xfa273/NucleoMouse2023/README.md

WMMCで2023年頃から使っている標準機体のソフトです．古いtoolchainでしかビルドできない問題を修正してあるはずです．
