xfa273/NucleoMouse2023/hardware/cad/Nucleo_Mouse_Sensor-Bord_2023-0908.pdf

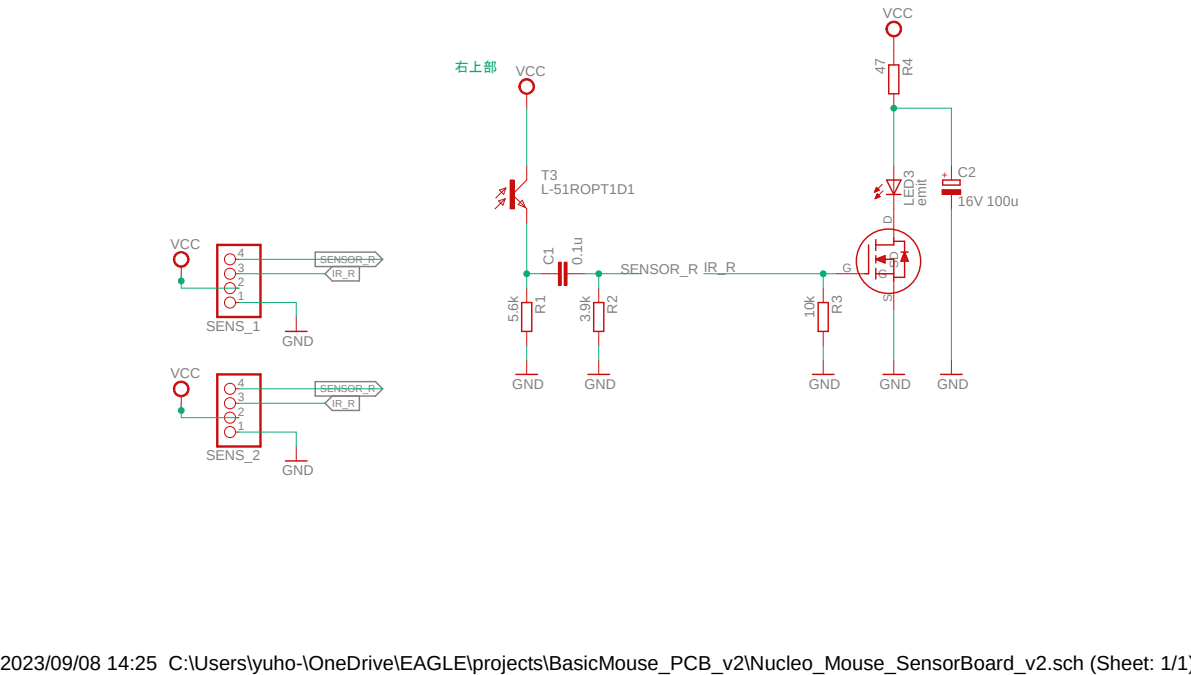
[picture p1: page 1]
2023/09/08 14:25 C:\Users\yuho-\OneDrive\EAGLE\projects\BasicMouse_PCB_v2\Nucleo_Mouse_SensorBoard_v2.sch (Sheet: 1/1) ⁵.6k; GND; L-51ROPT1D1; VCC; GND emit; C2 LED³ D; 4 SENS_1; 4 SENS_2; SENSOR_R; 右上部
