xfa273/NucleoMouse2023/hardware/cad/Nucleo_Mouse_Main-Bord_2023-0908.pdf

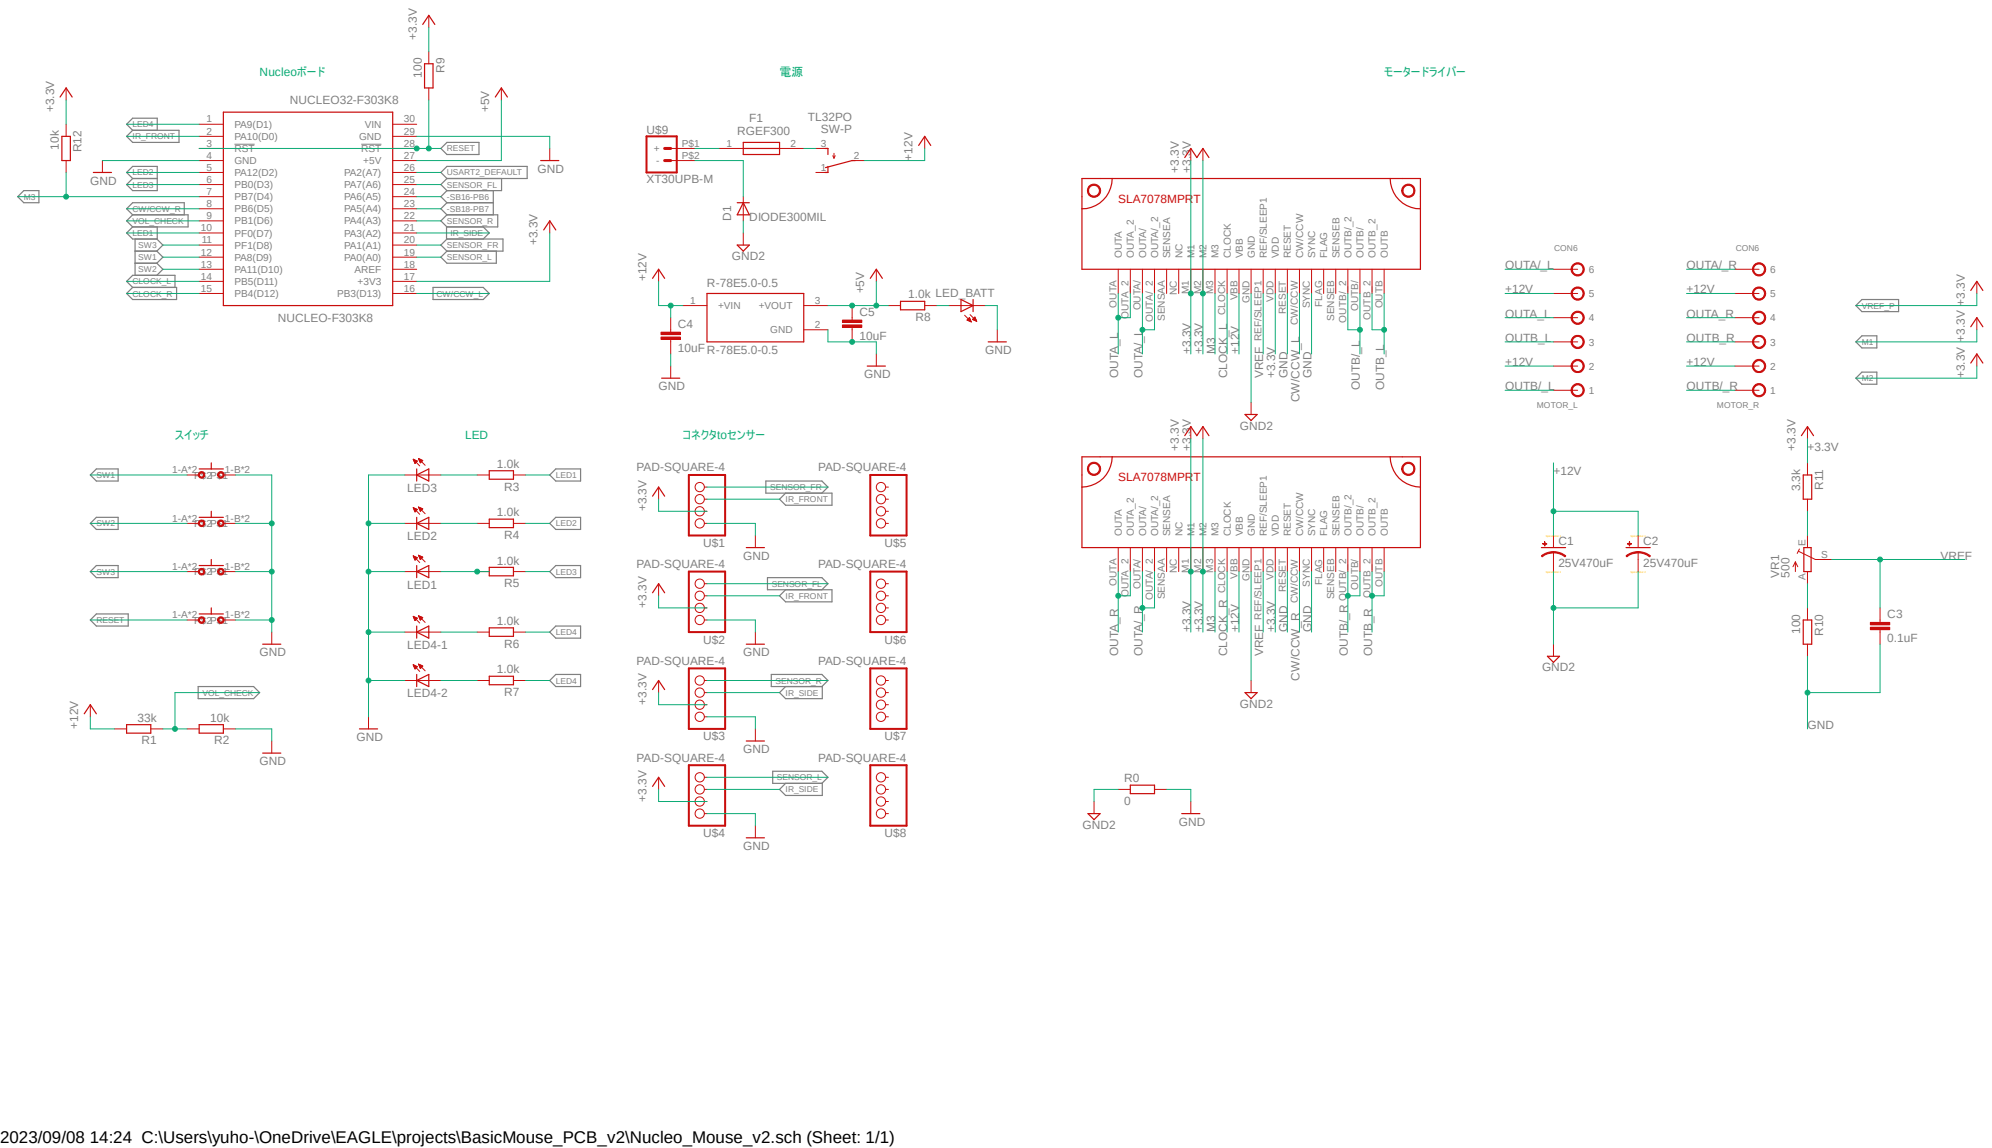
[picture p2: page 1]

2023/09/08 14:24 C:\Users\yuho-\OneDrive\EAGLE\projects\BasicMouse_PCB_v2\Nucleo_Mouse_v2.sch (Sheet: 1/1)
