xfa273/NucleoMouse2023/hardware/cad/Nucleo_Mouse_v2.brd

## EAGLE design hardware/cad/Nucleo_Mouse_v2.brd (2026-04-15)

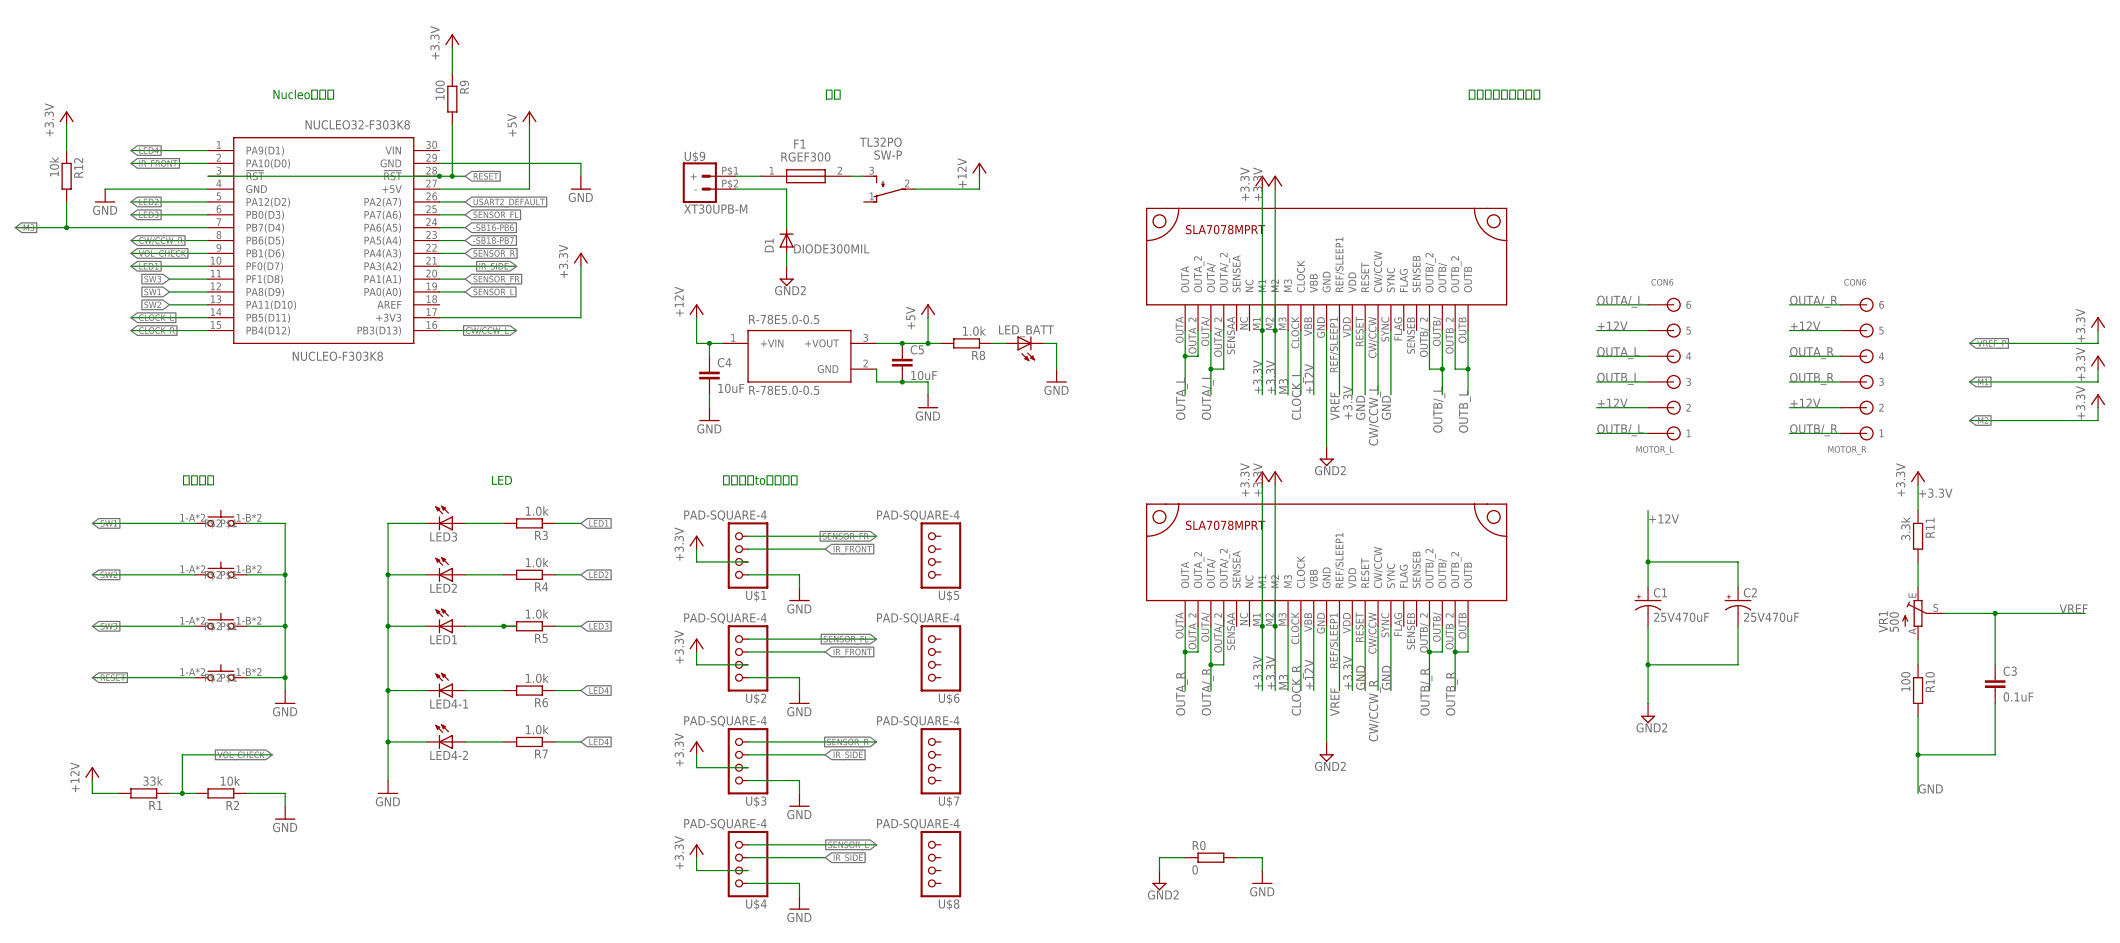
[picture p3: schematic Nucleo_Mouse_v2.sch]

Parts:
C1, C2: 25V470uF; E5-10,5
C3: 0.1uF; C050-024X044
C4, C5: 10uF; C050-024X044
D1: DIODE300MIL; D-7.5
DRIVER_L: SLA7078VANILLA; SLA7078_VANILLA
DRIVER_R: SLA7078VANILLA; SLA7078_VANILLA
F1: RGEF300
LED1, LED2, LED3, LED4-1, LED4-2: LED3MM
LED_BATT: LED3MM
MOTOR_L: CON6
MOTOR_R: CON6
NUCLEO32-F303K8: NUCLEO-F303K8; DIPS1524W66P254L5029H1500Q30N
R0: 0; 0204/7
R1: 33k; 0204/7
R2, R12: 10k; 0204/7
R3, R4, R5, R6, R7, R8: 1.0k; 0204/7
R9, R10: 100; 0204/7
R11: 3.3k; 0204/7
R-78E5.0-0.5: R-78E5.0-0.5; CONV_R-78E5.0-0.5
SW1, SW2, SW3: TACT_SW; AKI_TACT
SW-P: TL32PO; TL3XPO
SW_RESET: TACT_SW; AKI_TACT
U$1, U$2, U$3, U$4, U$5, U$6, U$7, U$8: PAD-SQUARE-4; PAD-SQUARE-2.54
U$9: XT30UPB-M
VR1: 500; B25P

Connections:
+3.3V: DRIVER_L.M1, DRIVER_L.M2, DRIVER_L.VDD, DRIVER_R.M1, DRIVER_R.M2, DRIVER_R.VDD, NUCLEO32-F303K8.17 (+3V3), R9.1, R11.1, R12.1, U$1.2-1 (2), U$1.2-2 (2), U$2.2-1 (2), U$2.2-2 (2), U$3.2-1 (2), U$3.2-2 (2), U$4.2-1 (2), U$4.2-2 (2)
+5V: C5.1, NUCLEO32-F303K8.27 (+5V), R8.2, R-78E5.0-0.5.3 (+VOUT)
+12V: C1.+, C2.+, C4.1, DRIVER_L.VBB, DRIVER_R.VBB, MOTOR_L.P$2 (2), MOTOR_L.P$5 (5), MOTOR_R.P$2 (2), MOTOR_R.P$5 (5), R1.2, R-78E5.0-0.5.1 (+VIN), SW-P.2
-SB16-PB6: NUCLEO32-F303K8.24 (PA6(A5))
-SB18-PB7: NUCLEO32-F303K8.23 (PA5(A4))
CLOCK_L: DRIVER_L.CLOCK, NUCLEO32-F303K8.14 (PB5(D11))
CLOCK_R: DRIVER_R.CLOCK, NUCLEO32-F303K8.15 (PB4(D12))
CW/CCW_L: DRIVER_L.CW/CCW, NUCLEO32-F303K8.16 (PB3(D13))
CW/CCW_R: DRIVER_R.CW/CCW, NUCLEO32-F303K8.8 (PB6(D5))
GND: C3.2, C4.2, C5.2, DRIVER_L.RESET, DRIVER_L.SYNC, DRIVER_R.RESET, DRIVER_R.SYNC, LED1.K (C), LED2.K (C), LED3.K (C), LED4-1.K (C), LED4-2.K (C), LED_BATT.K (C), NUCLEO32-F303K8.4 (GND), NUCLEO32-F303K8.29 (GND), R0.2, R2.1, R10.2, R-78E5.0-0.5.2 (GND), SW1.1-B, SW1.2-B, SW2.1-B, SW2.2-B, SW3.1-B, SW3.2-B, SW_RESET.1-B, SW_RESET.2-B, U$1.1-1 (1), U$1.1-2 (1), U$2.1-1 (1), U$2.1-2 (1), U$3.1-1 (1), U$3.1-2 (1), U$4.1-1 (1), U$4.1-2 (1)
GND2: C1.-, C2.-, D1.A, DRIVER_L.GND, DRIVER_R.GND, R0.1
IR_FRONT: NUCLEO32-F303K8.2 (PA10(D0)), U$1.3-1 (3), U$1.3-2 (3), U$2.3-1 (3), U$2.3-2 (3)
IR_SIDE: NUCLEO32-F303K8.21 (PA3(A2)), U$3.3-1 (3), U$3.3-2 (3), U$4.3-1 (3), U$4.3-2 (3)
LED1: NUCLEO32-F303K8.10 (PF0(D7)), R3.1
LED2: NUCLEO32-F303K8.5 (PA12(D2)), R4.1
LED3: NUCLEO32-F303K8.6 (PB0(D3)), R5.1
LED4: NUCLEO32-F303K8.1 (PA9(D1)), R6.1, R7.1
M3: DRIVER_L.M3, DRIVER_R.M3, NUCLEO32-F303K8.7 (PB7(D4)), R12.2
unnamed: F1.1, U$9.P$1 (+)
unnamed: LED4-1.A, R6.2
unnamed: LED4-2.A, R7.2
unnamed: LED3.A, R3.2
unnamed: LED2.A, R4.2
unnamed: LED1.A, R5.2
unnamed: LED_BATT.A, R8.1
unnamed: D1.C, U$9.P$2 (-)
unnamed: F1.2, SW-P.3 (S)
unnamed: R10.1, VR1.A
unnamed: R11.2, VR1.E
OUTA/_L: DRIVER_L.OUTA/, DRIVER_L.OUTA/_2, MOTOR_L.P$6 (6)
OUTA/_R: DRIVER_R.OUTA/, DRIVER_R.OUTA/_2, MOTOR_R.P$6 (6)
OUTA_L: DRIVER_L.OUTA, DRIVER_L.OUTA_2, MOTOR_L.P$4 (4)
OUTA_R: DRIVER_R.OUTA, DRIVER_R.OUTA_2, MOTOR_R.P$4 (4)
OUTB/_L: DRIVER_L.OUTB/, DRIVER_L.OUTB/_2, MOTOR_L.P$1 (1)
OUTB/_R: DRIVER_R.OUTB/, DRIVER_R.OUTB/_2, MOTOR_R.P$1 (1)
OUTB_L: DRIVER_L.OUTB, DRIVER_L.OUTB_2, MOTOR_L.P$3 (3)
OUTB_R: DRIVER_R.OUTB, DRIVER_R.OUTB_2, MOTOR_R.P$3 (3)
RESET: NUCLEO32-F303K8.3 (!RST), NUCLEO32-F303K8.28 (!RST), R9.2, SW_RESET.1-A, SW_RESET.2-A
SENSOR_FL: NUCLEO32-F303K8.25 (PA7(A6)), U$2.4-1 (4), U$2.4-2 (4)
SENSOR_FR: NUCLEO32-F303K8.20 (PA1(A1)), U$1.4-1 (4), U$1.4-2 (4)
SENSOR_L: NUCLEO32-F303K8.19 (PA0(A0)), U$4.4-1 (4), U$4.4-2 (4)
SENSOR_R: NUCLEO32-F303K8.22 (PA4(A3)), U$3.4-1 (4), U$3.4-2 (4)
SW1: NUCLEO32-F303K8.12 (PA8(D9)), SW1.1-A, SW1.2-A
SW2: NUCLEO32-F303K8.13 (PA11(D10)), SW2.1-A, SW2.2-A
SW3: NUCLEO32-F303K8.11 (PF1(D8)), SW3.1-A, SW3.2-A
USART2_DEFAULT: NUCLEO32-F303K8.26 (PA2(A7))
VOL_CHECK: NUCLEO32-F303K8.9 (PB1(D6)), R1.1, R2.2
VREF: C3.1, DRIVER_L.REF/SLEEP1, DRIVER_R.REF/SLEEP1, VR1.S

Notes on the sheet:
スイッチ
LED
コネクタtoセンサー
モータードライバー
Nucleoボード

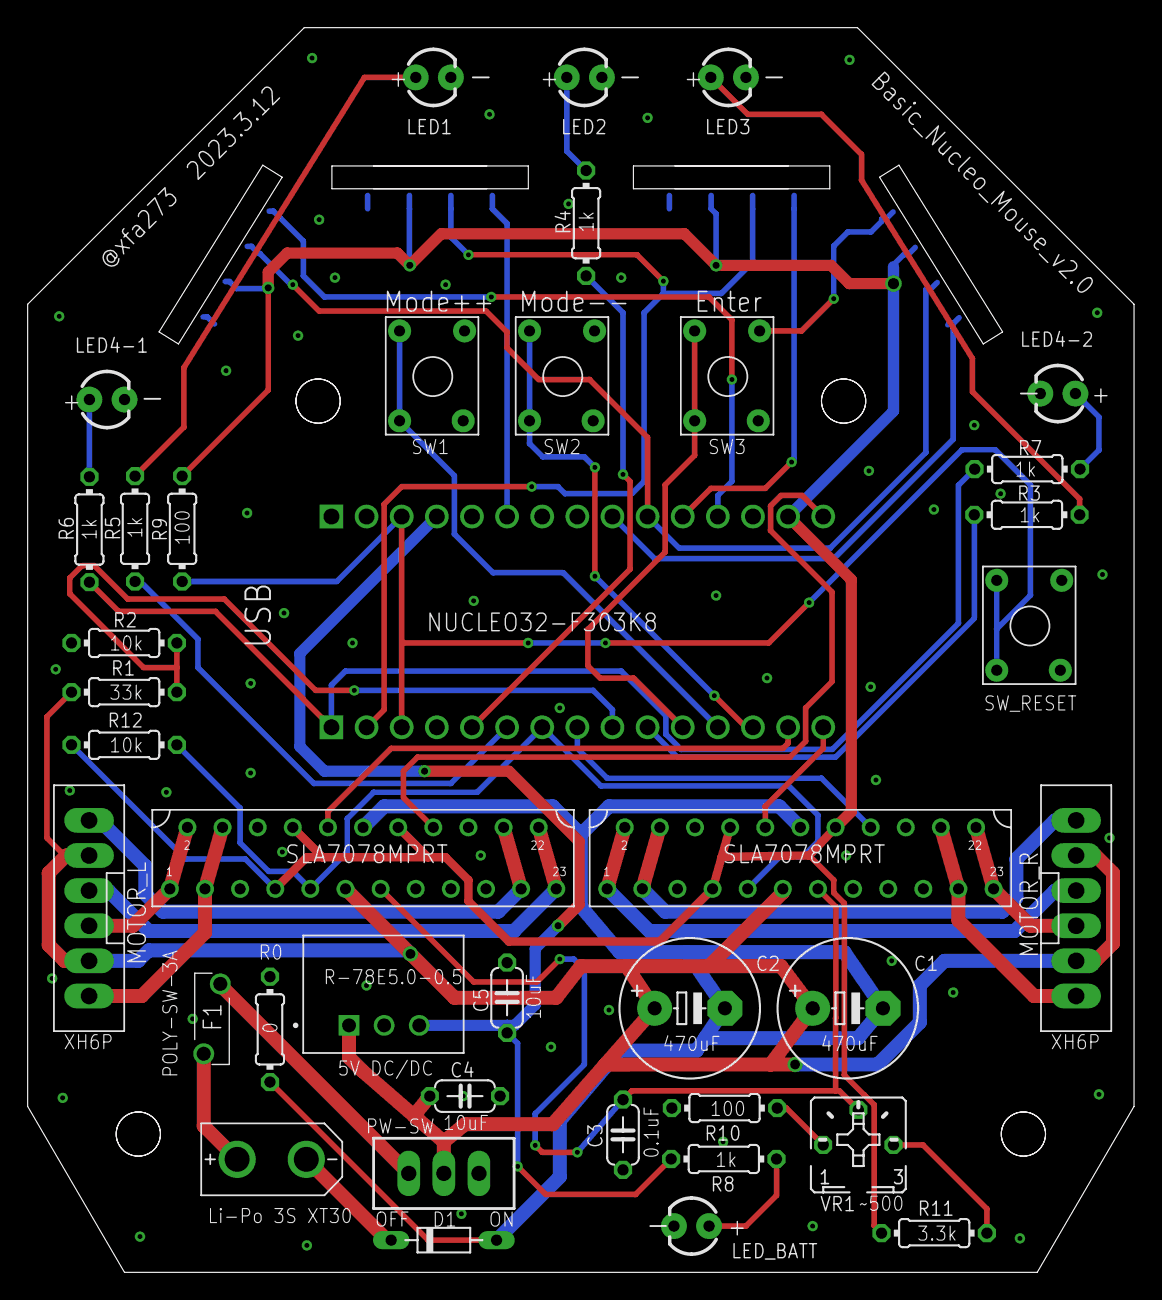
[picture p4: board Nucleo_Mouse_v2.brd from above]

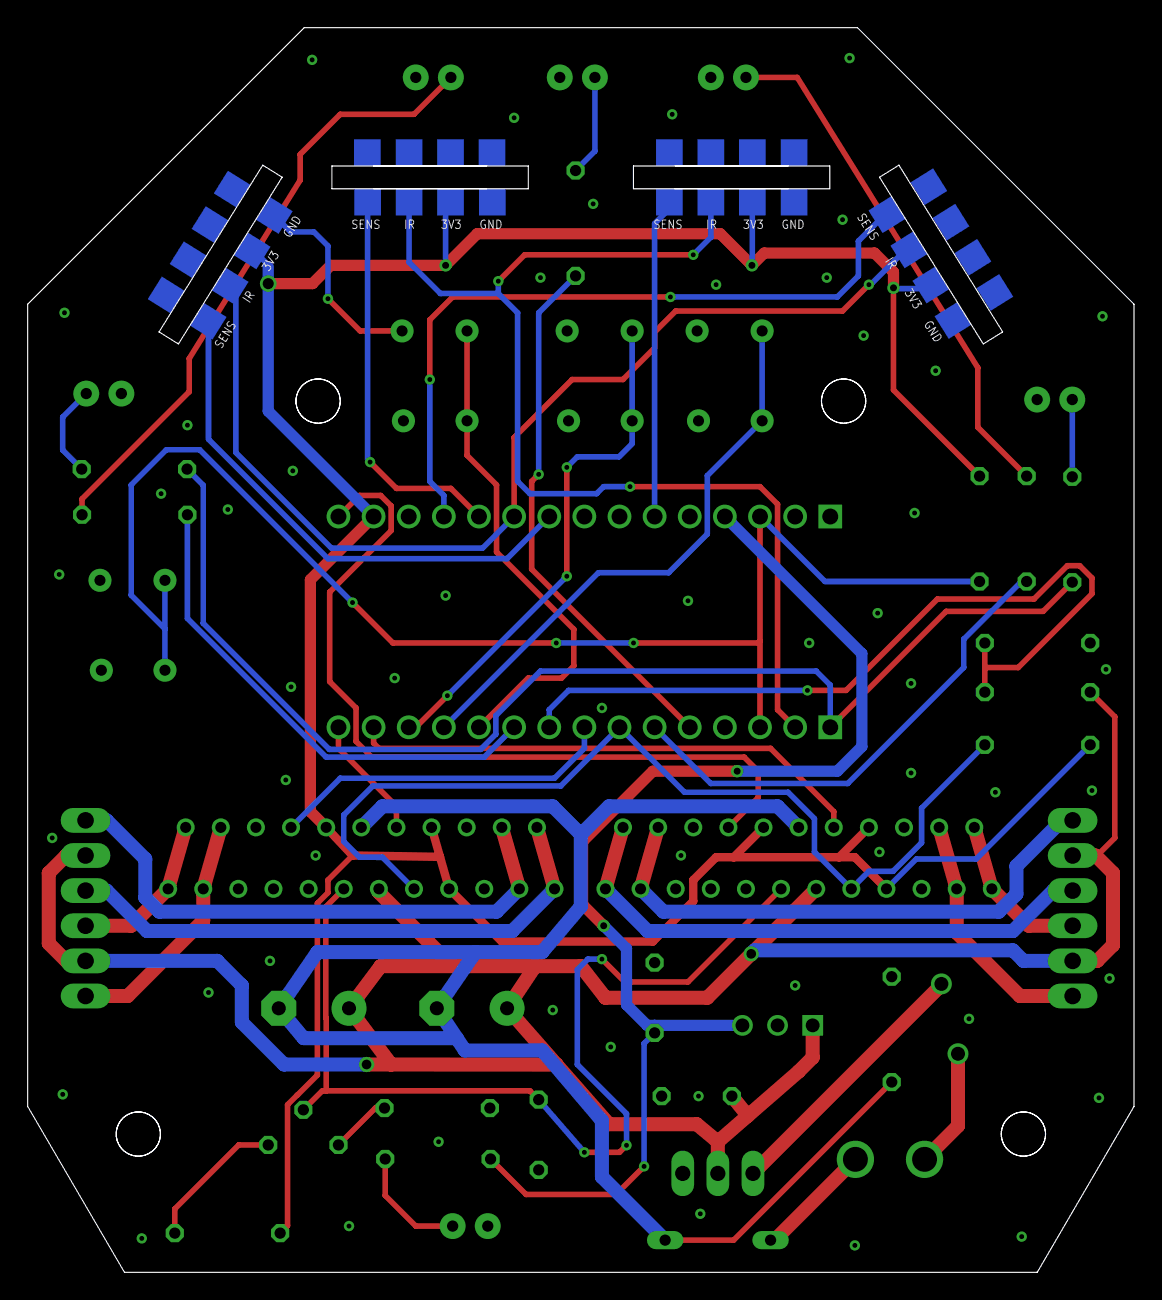
[picture p5: board Nucleo_Mouse_v2.brd from below]

Board: 2 copper layers, 80.0 x 90.0 mm, 47 parts (8 on the bottom side), 45 nets.
