xfa273/NucleoMouse2023/hardware/cad/Nucleo_Mouse_SensorBoard_v2.brd

## EAGLE design hardware/cad/Nucleo_Mouse_SensorBoard_v2.brd (2026-04-15)

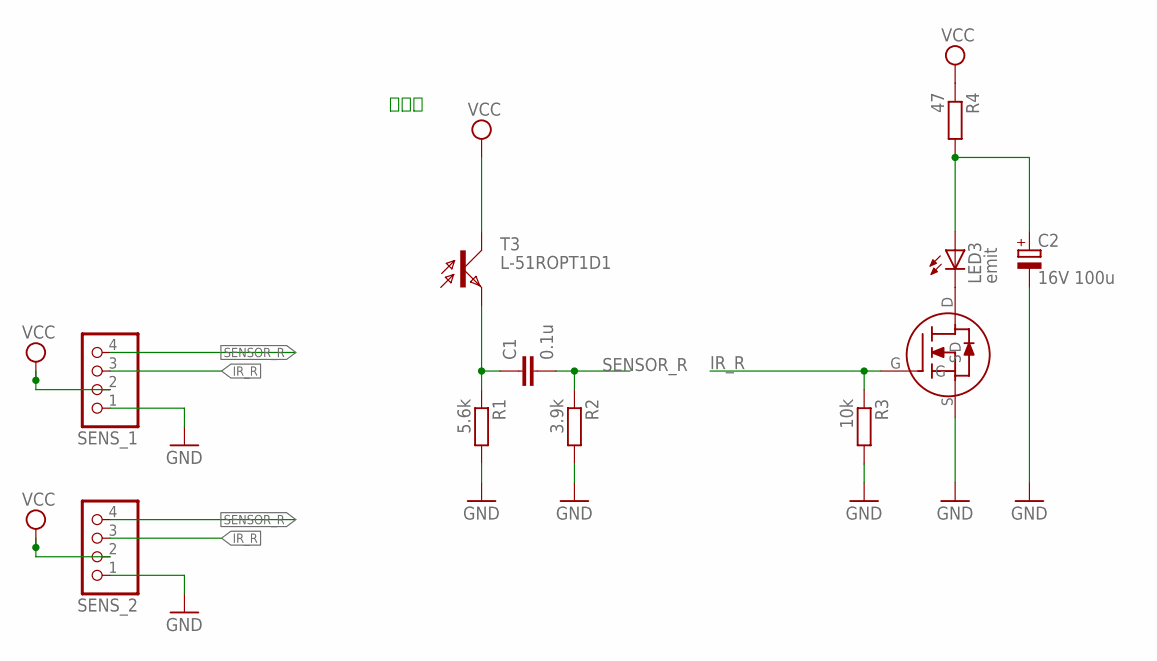
[picture p6: schematic Nucleo_Mouse_SensorBoard_v2.sch]

Parts:
2N2: 2N7000
C1: 0.1u; C2.5-3
C2: 16V 100u; E2-4
LED3: emit; LED5MM
R1: 5.6k; 0204/7
R2: 3.9k; 0204/7
R3: 10k; 0204/7
R4: 47; 0204/7
SENS_1, SENS_2: TP-1X4; 1X04
T3: L-51ROPT1D1

Connections:
GND: 2N2.S, C2.-, R1.2, R2.2, R3.2, SENS_1.1, SENS_2.1
IR_R: 2N2.G, R3.1, SENS_1.3, SENS_2.3
unnamed: C2.+, LED3.A, R4.2
unnamed: 2N2.D, LED3.K (C)
unnamed: C1.1, R1.1, T3.EMITTER (E)
SENSOR_R: C1.2, R2.1, SENS_1.4, SENS_2.4
VCC: R4.1, SENS_1.2, SENS_2.2, T3.COLLECTOR (C)

Notes on the sheet:
右上部

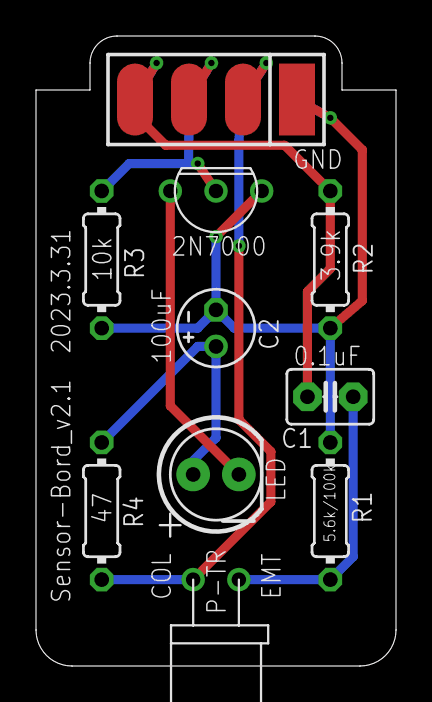
[picture p7: board Nucleo_Mouse_SensorBoard_v2.brd from above]

Board: 2 copper layers, 20.0 x 35.0 mm, 11 parts (1 on the bottom side), 7 nets.
