xfa273/NucleoMouse2023/Core/Src/main.c

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
/* Includes ------------------------------------------------------------------*/
#include "main.h"

/* USER CODE BEGIN Includes */

#define MAIN_C_
#include "global.h"

/* USER CODE END Includes */

ADC_HandleTypeDef hadc1;
ADC_HandleTypeDef hadc2;

TIM_HandleTypeDef htim6;
TIM_HandleTypeDef htim16;
TIM_HandleTypeDef htim17;

UART_HandleTypeDef huart2;

void SystemClock_Config(void);
static void MX_GPIO_Init(void);
static void MX_ADC1_Init(void);
static void MX_ADC2_Init(void);
static void MX_TIM6_Init(void);
static void MX_TIM16_Init(void);
static void MX_TIM17_Init(void);
static void MX_USART2_UART_Init(void);
/**
  * @brief  The application entry point.
  * @retval int
  */
int main(void)
{
  /* MCU Configuration--------------------------------------------------------*/

  /* Reset of all peripherals, Initializes the Flash interface and the Systick. */
  HAL_Init();

  /* Configure the system clock */
  SystemClock_Config();

  /* Initialize all configured peripherals */
  MX_GPIO_Init();
  MX_ADC1_Init();
  MX_ADC2_Init();
  MX_TIM6_Init();
  MX_TIM16_Init();
  MX_TIM17_Init();
  MX_USART2_UART_Init();
  /* USER CODE BEGIN 2 */

    setbuf(stdout, NULL);  // printf用

    sensor_init();

    drive_init();

    search_init();

    printf("***** WMMC Nucleo Mouse 2023 *****\n");


    int mode = 0;

  /* USER CODE END 2 */

  /* Infinite loop */
  /* USER CODE BEGIN WHILE */
    while (1) {

        mode = select_mode(
            mode);


        switch (mode) {
            case 0:



                printf("Mode 0: Get Base Value.\n");
                get_base();

                break;

            case 1:

                printf("Mode 1: 1st Run.\n");
                drive_enable_motor();


                MF.FLAG.SCND = 0;  // 二次走行フラグをクリア
                                   // マウスフラグはglobal.h に定義あり
                goal_x = GOAL_X;
                goal_y = GOAL_Y;  // ゴール座標を設定，GOAL_X・GOAL_Y はglobal.h
                                  // に定義あり

                rotate_R90();
                drive_wait();
                set_position(0);  // 尻当てをして機体位置を中央へ drive.c

                drive_wait();
                rotate_L90();
                drive_wait();
                set_position(0);  // 尻当てをして機体位置を中央へ
                drive_wait();

                get_base();

                searchB();
                HAL_Delay(500);

                goal_x = goal_y = 0;
                searchB();

                goal_x = GOAL_X;
                goal_y = GOAL_Y;

                drive_disable_motor();
                break;

            case 2:

                printf("Mode 2: 2nd Run.\n");
                drive_enable_motor();

                MF.FLAG.SCND = 1;
                goal_x = GOAL_X;
                goal_y = GOAL_Y;

                rotate_R90();
                drive_wait();
                set_position(0);
                drive_wait();
                rotate_L90();
                drive_wait();
                set_position(0);
                drive_wait();

                get_base();

                searchB();
                HAL_Delay(500);

                goal_x = goal_y = 0;
                searchB();

                goal_x = GOAL_X;
                goal_y = GOAL_Y;

                drive_disable_motor();
                break;

            case 3:





                printf("Mode 3: .\n");

                break;

            case 4:


                printf("Mode 4: .\n");
                break;

            case 5:


                printf("Mode 5: .\n");
                break;

            case 6:



                printf("Mode 6: Test Run.\n");
                test_run();
                break;

            case 7:



                printf("Sensor Check.\n");
                while (1) {
                    get_wall_info();
                    led_write(wall_info & 0x44, wall_info & 0x88,
                              wall_info & 0x11);
                    printf(
                        " ad_l : %4lu, ad_fl : %4lu, ad_fr : %4lu, ad_r : %4lu, "
                        "ad_batt : %4lu\n",
                        ad_l, ad_fl, ad_fr, ad_r, ad_batt);
                    printf("dif_l : %4d, dif_r : %4d\n", dif_l, dif_r);
                    if (wall_info & 0x11) {
                        printf("Left : [X], ");
                    } else {
                        printf("Left : [ ], ");
                    }
                    if (wall_info & 0x88) {
                        printf("Front : [X], ");
                    } else {
                        printf("Front : [ ], ");
                    }
                    if (wall_info & 0x44) {
                        printf("Right : [X]\n");
                    } else {
                        printf("Right : [ ]\n");
                    }





                    // printf("ad_batt : %4d\n", ad_batt);

                    HAL_Delay(333);
                }
                break;
        }

    /* USER CODE END WHILE */

    /* USER CODE BEGIN 3 */
    }
  /* USER CODE END 3 */
}

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
