xfa273/NucleoMouse2023/NucleoMouse2023.ioc

Mcu.UserName=STM32F303K8Tx
PA0.GPIO_Label=SENSOR_L
PA0.Signal=ADC1_IN1
PA1.GPIO_Label=SENSOR_FR
PA1.Signal=ADC1_IN2
PA10.GPIO_Label=IR_FRONT
PA10.Signal=GPIO_Output
PA11.GPIO_Label=SW2
PA11.Signal=GPIO_Input
PA12.GPIO_Label=LED2
PA12.Signal=GPIO_Output
PA13.GPIO_Label=SWDIO
PA13.Signal=SYS_JTMS-SWDIO
PA14.GPIO_Label=SWCLK
PA14.Signal=SYS_JTCK-SWCLK
PA15.GPIO_Label=VCP_RX
PA15.Signal=USART2_RX
PA2.GPIO_Label=VCP_TX
PA2.Signal=USART2_TX
PA3.GPIO_Label=IR_SIDE
PA3.Signal=GPIO_Output
PA4.GPIO_Label=SENSOR_R
PA4.Signal=ADC2_IN1
PA5.GPIO_Label=M3_2
PA5.Signal=GPIO_Output
PA6.GPIO_Label=CW/CCW_R_2
PA6.Signal=GPIO_Output
PA7.GPIO_Label=SENSOR_FL
PA7.Signal=ADC2_IN4
PA8.GPIO_Label=SW1
PA8.Signal=GPIO_Input
PA9.GPIO_Label=LED4
PA9.Signal=GPIO_Output
PB0.GPIO_Label=LED3
PB0.Signal=GPIO_Output
PB1.GPIO_Label=VOL_CHECK
PB1.Signal=ADC1_IN12
PB3.GPIO_Label=CW/CCW_L
PB3.Signal=GPIO_Output
PB4.GPIO_Label=CLOCK_R
PB4.Signal=S_TIM16_CH1
PB5.GPIO_Label=CLOCK_L
PB5.Signal=S_TIM17_CH1
PB6.GPIO_Label=CW/CCW_R
PB6.Signal=GPIO_Output
PB7.GPIO_Label=M3
PB7.Signal=GPIO_Output
