xfa273/NucleoMouse2023/(commit log)

2026-04-15 chore: organize hardware CAD and gerber data for cross-platform import
    [Nucleo_Mouse_BasePlate_v2.brd, Nucleo_Mouse_SensorBoard_v2.brd, Nucleo_Mouse_SensorBoard_v2.sch, Nucleo_Mouse_v2.brd, Nucleo_Mouse_v2.sch]
2026-04-15 chore: normalize hardware file permissions
    [Nucleo_Mouse_BasePlate_v2.brd, Nucleo_Mouse_SensorBoard_v2.brd, Nucleo_Mouse_SensorBoard_v2.sch, Nucleo_Mouse_v2.brd, Nucleo_Mouse_v2.sch]
